cnbright/pascalline/archive/README.md

# 历史资料

`v1/` 保留早期建模、原理图、静态姿态工具和打印评估；其中弹性爪、导向支承和行程设计已由根目录 V0.2 替代。旧图、价格估算和旧 README 中的文件链接不代表当前交付，也不保证仍可直接访问。

`history/` 保存后来被替换的几何验证实现，不能作为当前通过证据。当前入口为根目录 `tools/rebuild.py`，当前打印文件为 `exports/obj/`。

未收录可以重新生成的大型 Blender 缓存、临时日志、网页抓取缓存和旧打印件。保留历史原理图的生成源码与轮廓；重画旧图另需 Matplotlib，不属于当前 requirements.txt 的恢复必需依赖。
