cnbright/pascalline/exports/part_previews/base.png

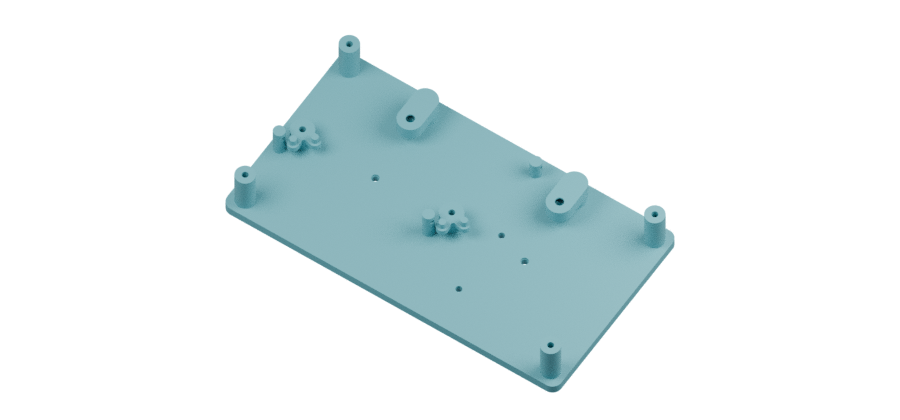
exports/part_previews/base.png
