cnbright/pascalline/exports/part_previews/carry_slider.png

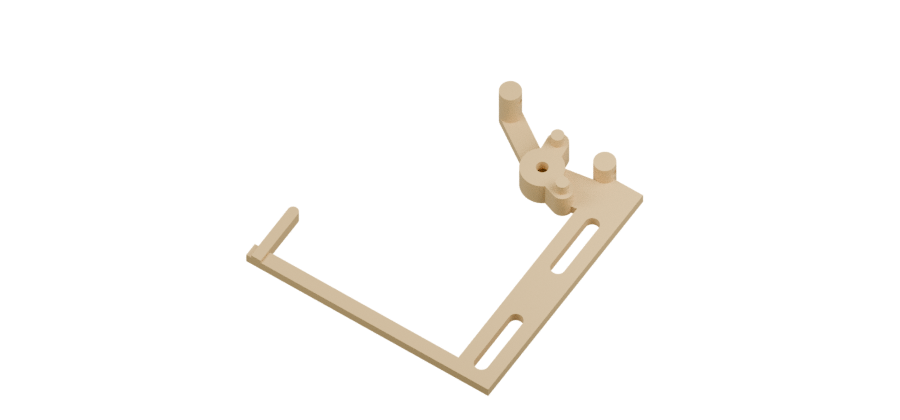
exports/part_previews/carry_slider.png
