cnbright/pascalline/exports/part_previews/digit_wheel.png

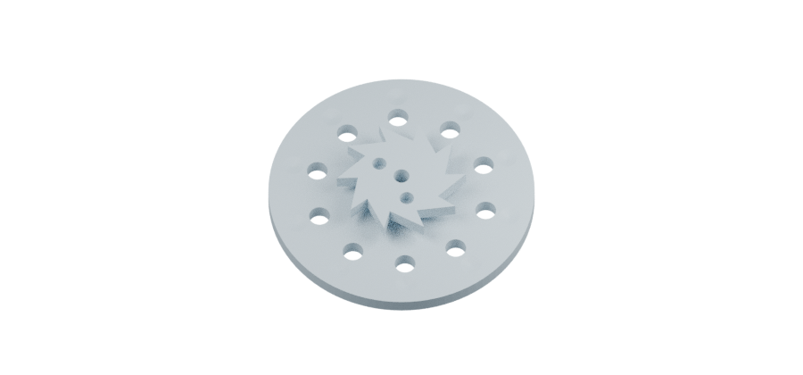
exports/part_previews/digit_wheel.png
