cnbright/pascalline/exports/part_previews/drive_pawl.png

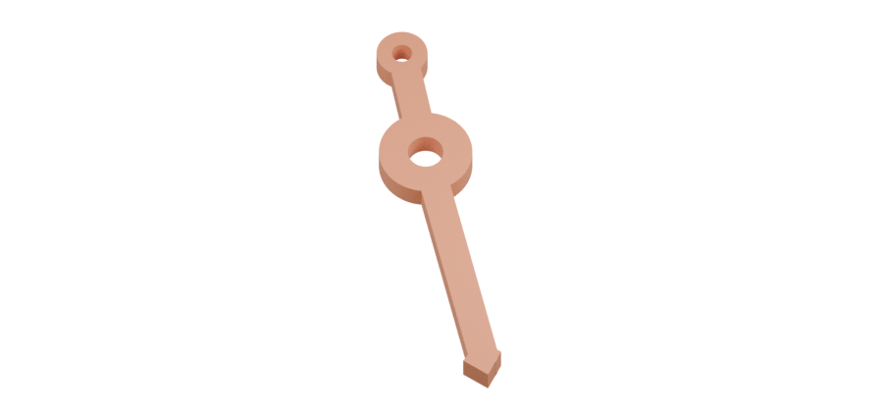
exports/part_previews/drive_pawl.png
