cnbright/pascalline/exports/part_previews/stop_pawl.png

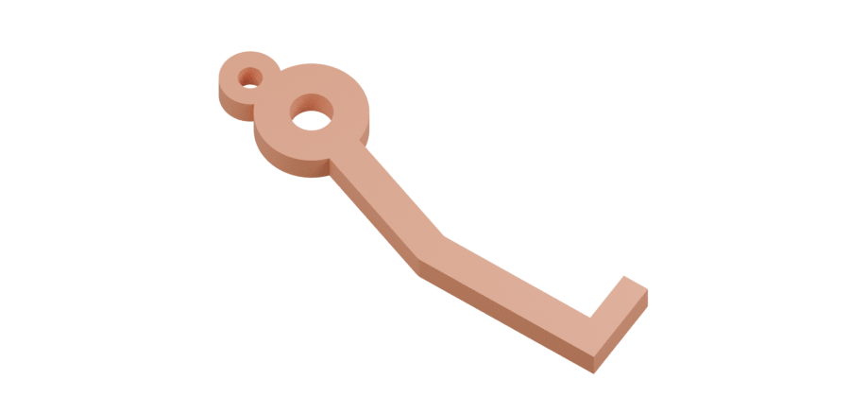
exports/part_previews/stop_pawl.png
