cnbright/pascalline/exports/part_previews/top_cover.png

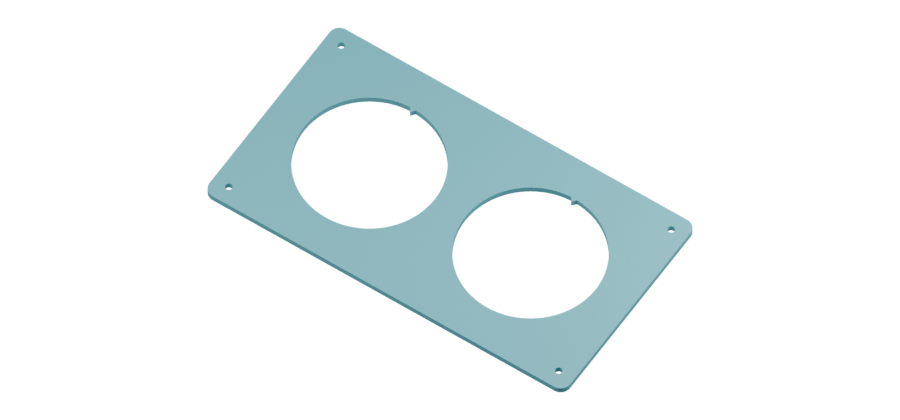
exports/part_previews/top_cover.png
