cnbright/pascalline/HARDWARE.csv

项目 | 规格 | 数量 | 单位 | 适用 | 用途与核对说明
金属轴管 | 外径4/内径3.2/长度25 mm | 2 | 段 | 必需 | 两轮空心轴；装配Z4到29；端面磨平去毛刺；内孔可自由通过M3
金属导向套 | 外径4/内径3.2/长度5 mm | 2 | 段 | 必需 | 固定位置(67 -30)和(67 6)；套顶Z10；外圆须平滑
金属枢轴套 | 外径4/内径3.2/长度4 mm | 3 | 段 | 必需 | 两止回爪加一驱动爪；套顶Z18
M3低圆头螺钉 | M3×35 头下长度 | 2 | 根 | 必需 | 轴管夹紧；配0.5mm上垫时尖端约Z-5.5
M3低圆头螺钉 | M3×16 头下长度 | 2 | 根 | 必需 | 滑架导向；不能直接加长为×18；需核对脚下净空
M3低圆头螺钉 | M3×25 头下长度 | 2 | 根 | 必需 | 固定止回爪穿底板；尖端约Z-6.5；8mm底脚名义余量1.5mm
M3低圆头螺钉 | M3×12 头下长度 | 1 | 根 | 必需 | 驱动爪；尖端约Z6.5；禁止直接换×14
M3上压平垫 | 内孔约3.2/外径约7/厚0.5 mm | 7 | 片 | 必需 | 轴2片加导向2片加三爪3片；必须压在金属套端面而非夹死运动件
M3底部平垫 | 内孔约3.2/外径7至9/厚0.5 mm | 6 | 片 | 必需 | 轴2片加导向2片加固定止回爪2片；分散底板局部压力
M3防松螺母 | M3尼龙锁紧型 高约4 mm | 6 | 个 | 必需 | 轴2个加导向2个加固定止回爪2个；实测高度改变后重算螺纹外露
M3普通六角螺母 | M3 对边5.5/厚2.4 mm | 1 | 个 | 必需 | 仅驱动爪座侧装；不能用较厚锁母代替
M4孔径下支承垫圈 | 内孔约4.3/外径8至9/厚1.0 mm | 2 | 片 | 必需 | 滑架下支承；可用实测0.8加0.2mm组合达到1.0mm
M4孔径上限位垫圈 | 内孔约4.3/外径8至9/厚0.8 mm | 2 | 片 | 必需 | 滑架上方浮动限位；名义防翘余隙0.2mm
M4孔径枢轴下调整垫 | 内孔约4.3/外径8至9/厚0.2 mm | 3 | 片 | 必需 | 三爪各一片；配合实测爪厚调整
M4孔径枢轴上调整垫 | 内孔约4.3/外径8至9/厚0.5 mm | 3 | 片 | 必需 | 三爪各一片；与L4套和3mm爪组成名义0.3mm轴隙
M4弹簧钢珠定位柱 | M4短体约8mm/球径约2.5mm/可用压缩行程至少0.7mm | 2 | 个 | 必需 | 核实供应商实物尺寸；自由球顶调至Z21.65且金属体顶低于21底高于10
M4普通六角螺母 | M4 对边7/厚约3.2 mm | 2 | 个 | 必需 | 钢珠支架侧装螺母；槽高约3.5mm
轻回位元件 | 可调弹力线或适配轻小拉簧 | 4 | 根 | 必需 | 三爪各一根加滑架一根；滑架端距约7.5至22.4mm；2.4mm穿线孔
橡胶底脚 | 约8mm高 自粘或可靠胶粘 | 4 | 个 | 必需 | 避开底部紧固件；检查压缩后螺钉不触桌；不足时加高
环氧胶 | 适配固化树脂和所选金属 | 少量 | 份 | 必需 | 仅胶固固定下轴套与管及底法兰与底座；校直固化；不得粘旋转面
螺纹防松用品 | 适配金属小螺纹的可复查防松措施 | 少量 | 份 | 按需 | 驱动侧装普通螺母及钢珠调节螺纹等；避免胶液进入树脂配合面和钢珠机构
薄调整垫片 | 内孔适配4mm套的多种薄厚规格 | 少量 | 组 | 按需 | 用于实物公差选配；不得以强拧螺钉消除间隙
M3盖板螺钉 | M3×35 头下长度 | 4 | 根 | 仅装盖板 | 盖板Z26.5到29.5；配0.5mm上垫；不要换×40
M3盖板平垫 | 内孔约3.2/厚0.5 mm | 8 | 片 | 仅装盖板 | 上4片下4片；厚度变化须重算长度
M3盖板普通六角螺母 | M3 对边5.5/厚2.4 mm | 4 | 个 | 仅装盖板 | 约有2.1mm螺纹露出；须防松；换高4mm锁母只余约0.5mm须确认啮合
