cnbright/pascalline/exports/print_parts_overview.pdf

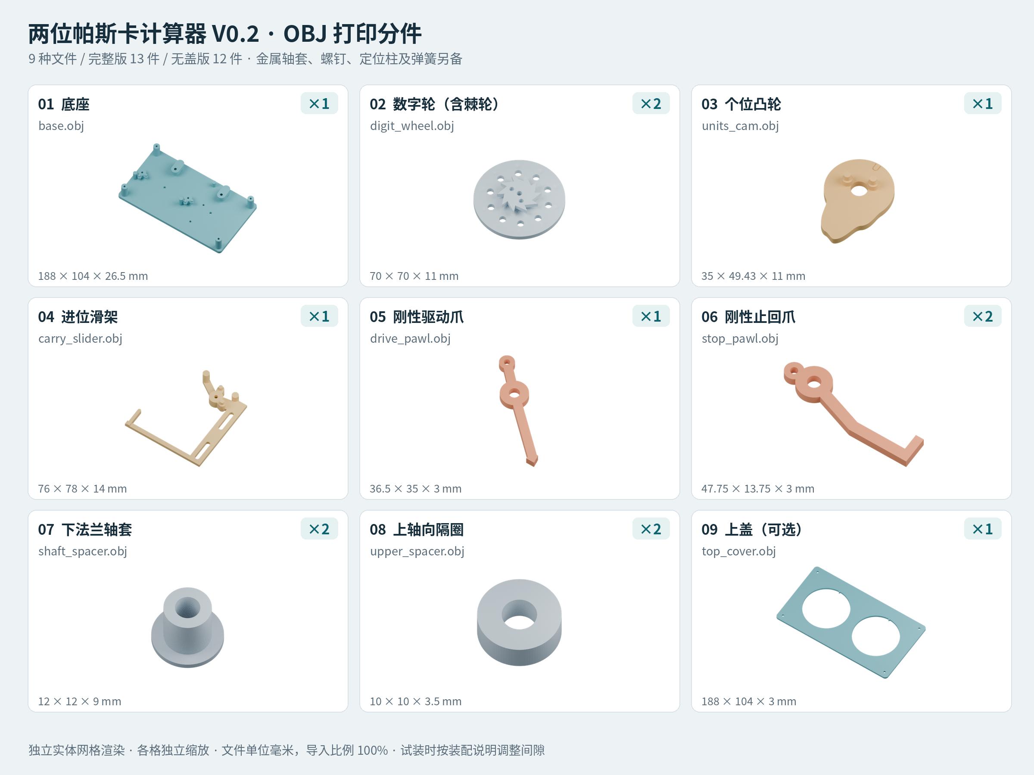
[picture p8: page 1]
