cnbright/pascalline/exports/parts.csv

文件 | 中文名称 | 数量 | 可选 | 单位 | X尺寸_mm | Y尺寸_mm | Z尺寸_mm | 单件体积_cm3 | 备注
obj/base.obj | 底座 | 1 | 否 | mm | 188.000 | 104.000 | 26.500 | 111.366394 | 每文件仅一个零件；请按数量生产
obj/digit_wheel.obj | 数字轮（含棘轮） | 2 | 否 | mm | 70.000 | 70.000 | 11.000 | 17.161875 | 每文件仅一个零件；请按数量生产
obj/units_cam.obj | 个位凸轮 | 1 | 否 | mm | 35.000 | 49.426 | 11.000 | 4.876861 | 每文件仅一个零件；请按数量生产
obj/carry_slider.obj | 进位滑架 | 1 | 否 | mm | 76.000 | 78.000 | 14.000 | 5.397358 | 每文件仅一个零件；请按数量生产
obj/drive_pawl.obj | 驱动拨爪 | 1 | 否 | mm | 36.500 | 35.000 | 3.000 | 0.649323 | 每文件仅一个零件；请按数量生产
obj/stop_pawl.obj | 止回爪 | 2 | 否 | mm | 47.750 | 13.750 | 3.000 | 0.699666 | 每文件仅一个零件；请按数量生产
obj/shaft_spacer.obj | 下法兰轴套 | 2 | 否 | mm | 12.000 | 12.000 | 9.000 | 0.390253 | 每文件仅一个零件；请按数量生产
obj/upper_spacer.obj | 上轴向隔圈 | 2 | 否 | mm | 10.000 | 10.000 | 3.500 | 0.226237 | 每文件仅一个零件；请按数量生产
obj/top_cover.obj | 上盖 | 1 | 是 | mm | 188.000 | 104.000 | 3.000 | 36.725614 | 每文件仅一个零件；请按数量生产；盖板可省略
