cnbright/pascalline/exports/top_cover.stl

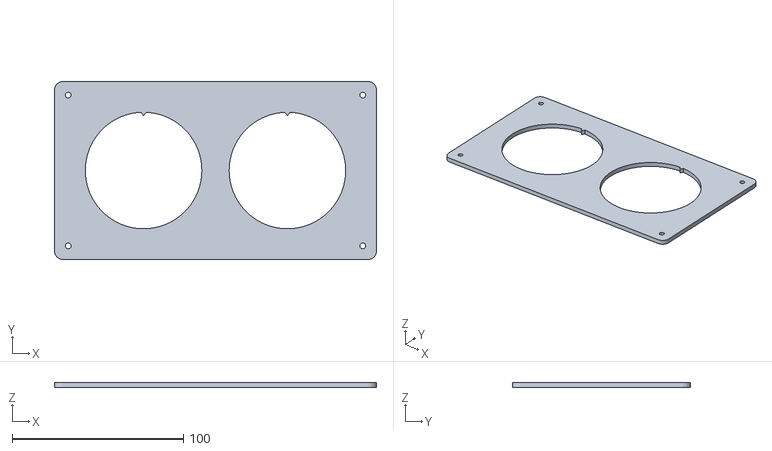
[picture p9: CAD file, 2026-10-18]
exports/top_cover.stl
188.0 x 104.0 x 3.00
