cnbright/pascalline/exports/units_cam.stl

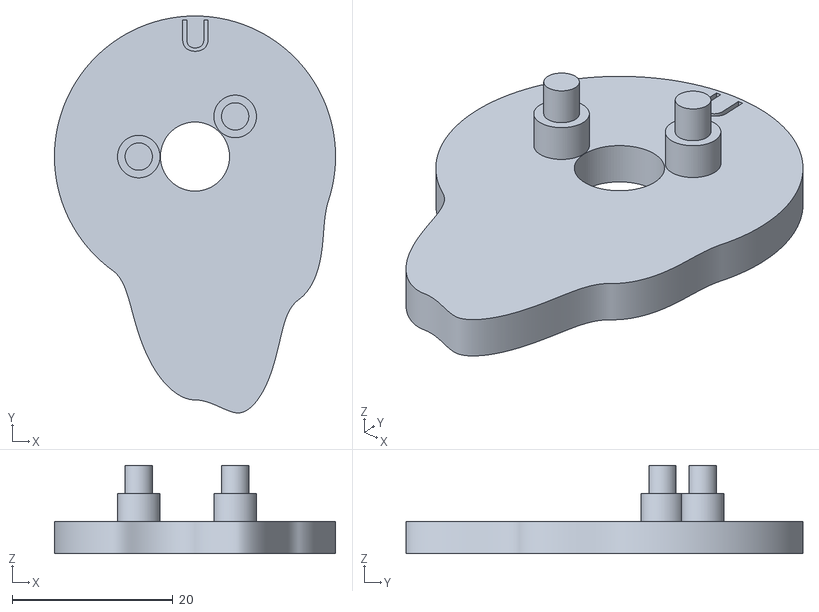
[picture p10: CAD file, 2026-10-18]
exports/units_cam.stl
35.0 x 49.4 x 11.0
