cnbright/pascalline/exports/digit_wheel.stl

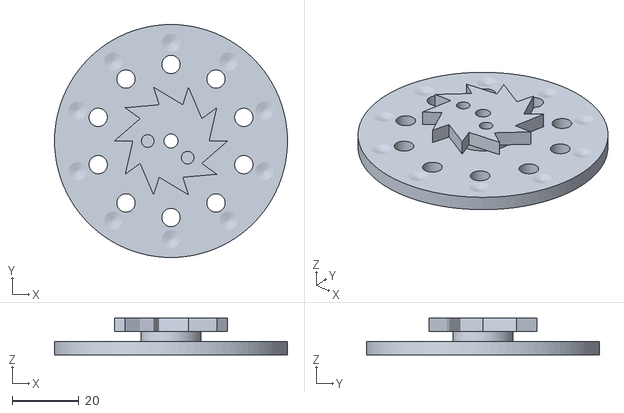
[picture p11: CAD file, 2026-10-18]
exports/digit_wheel.stl
70.0 x 70.0 x 11.0
