cnbright/pascalline/exports/shaft_spacer.stl

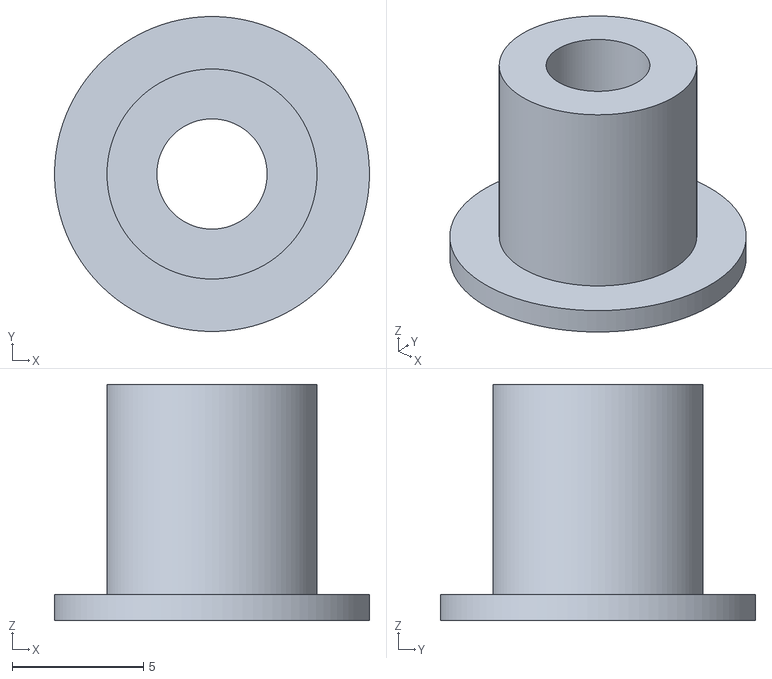
[picture p12: CAD file, 2026-10-18]
exports/shaft_spacer.stl
12.0 x 12.0 x 9.00
