cnbright/pascalline/exports/drive_pawl.stl

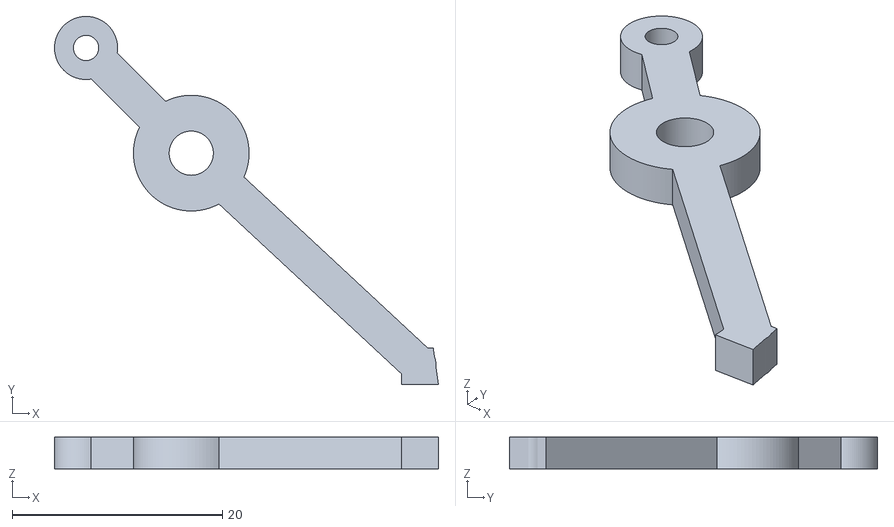
[picture p13: CAD file, 2026-10-18]
exports/drive_pawl.stl
36.5 x 35.0 x 3.00
