cnbright/pascalline/exports/base.stl

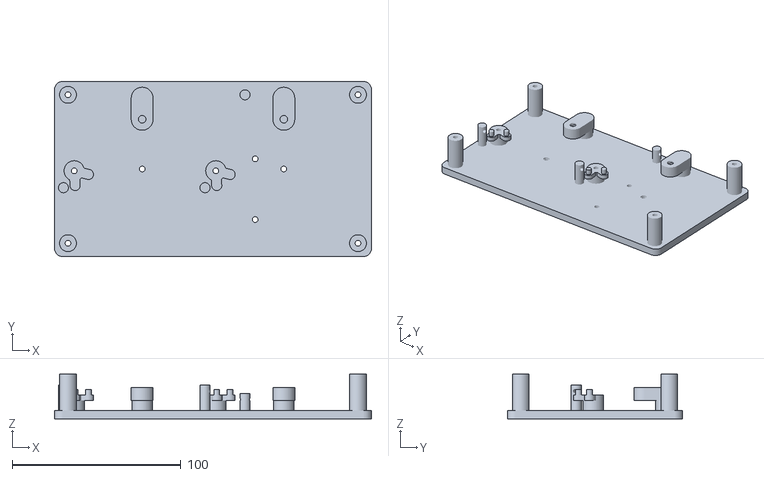
[picture p14: CAD file, 2026-10-18]
exports/base.stl
188.0 x 104.0 x 26.5
