cnbright/pascalline/exports/upper_spacer.stl

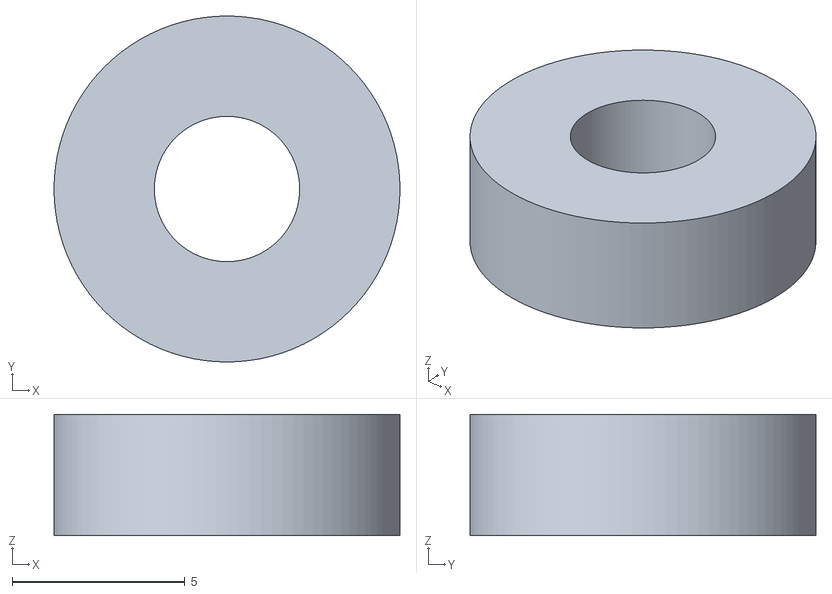
[picture p15: CAD file, 2026-10-18]
exports/upper_spacer.stl
10.0 x 10.0 x 3.50
