cnbright/pascalline/exports/stop_pawl.stl

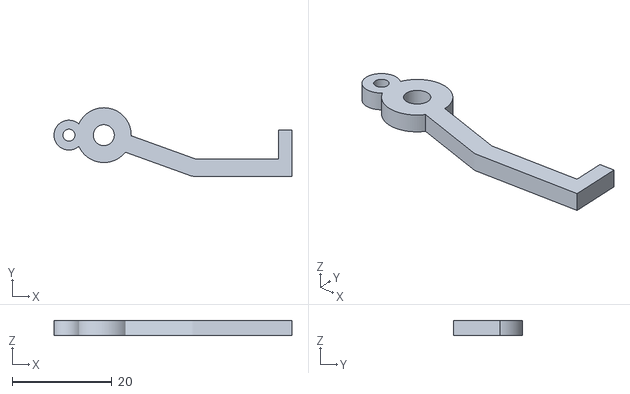
[picture p16: CAD file, 2026-10-18]
exports/stop_pawl.stl
47.8 x 13.8 x 3.00
