cnbright/pascalline/exports/carry_slider.stl

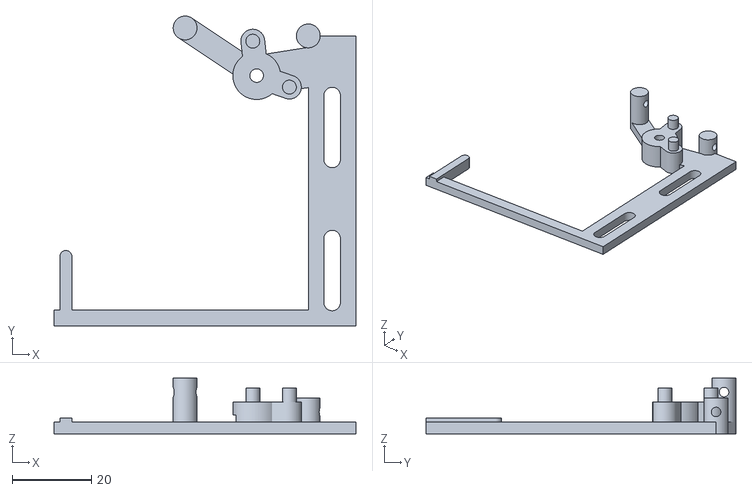
[picture p17: CAD file, 2026-10-18]
exports/carry_slider.stl
76.0 x 78.0 x 14.0
