cnbright/pascalline/(list of files, cad)

Other CAD files:
archive/v1/drawings/source/drive_pawl.scad
archive/v1/pascaline.scad
archive/v1/drawings/source/carry_slider.scad
archive/v1/drawings/source/ratchet_section.scad
archive/v1/drawings/source/stop_pawl.scad
archive/v1/drawings/source/units_cam.scad
