cnbright/pascalline/ASSEMBLY.md

# 帕斯卡两位计算器 V0.2：装配与调试

本版使用刚性打印爪、金属轴套、外置回位簧和弹簧钢珠定位。打印件建议使用 **9600 白树脂**；三只爪靠枢轴转动让位，**不能把树脂梁当弹片掰弯**。目前未做实物试打、寿命或负载验证，文件通过网格检查不代表量产可靠。

## 1. 清点零件与方向

| 打印文件 | 名称 | 数量 |
|---|---|---:|
| `base.obj` | 底座 | 1 |
| `digit_wheel.obj` | 数字轮，含棘轮 | 2 |
| `units_cam.obj` | 个位凸轮 | 1 |
| `carry_slider.obj` | 进位滑架 | 1 |
| `drive_pawl.obj` | 驱动拨爪 | 1 |
| `stop_pawl.obj` | 止回爪 | 2 |
| `shaft_spacer.obj` | 固定下法兰轴套 | 2 |
| `upper_spacer.obj` | 上轴向隔圈 | 2 |
| `top_cover.obj` | 上盖，可选 | 1 |

共 **9 种、13 件**；不装盖板为 **8 种、12 件**。每个 OBJ 只含一个零件，重复件按数量制造。OBJ 坐标单位按 **mm** 导入，禁止为补偿孔配合而整体缩放；数字轮导出时盘面朝下，装配时将有数字的一面朝上。

俯视时，左轮为个位，右轮为十位；读数先看右侧十位、再看左侧个位。两个轮均逆时针前进，每档 36°。读数位置在两个轴的 +Y 方向，即钢珠支架一侧。没有盖板时，在固定支架上补两个读数指示标记，不能用会跟轮转动的标记代替。

五金见同目录 `HARDWARE.csv`。除可选盖板五金外，核心用量是：7 根 M3 螺钉、6 个 M3 锁母、1 个侧装普通 M3 螺母、13 片 M3 平垫、10 片不同厚度的 M4 孔径垫片、7 段金属管、2 个弹簧钢珠定位柱和 4 根回位元件。

## 2. 打印后先处理配合面

去除支撑、清洗并完成材料要求的固化。支撑痕和涂层不能留在棘齿工作面、凸轮外轮廓、随动圆头、钢珠凹位、轴孔、滑槽和承托端面。数字可填色，但保护这些配合面。

以下是**成品配合目标**，不是免加工承诺。先测金属外径，再量打印件；用合适量规、细锉、铰刀和细砂纸逐步修整。孔已经偏大时不要继续扩孔，应换衬套或重做该件；不要用全局缩放同时改变轴距和进位几何。

| 位置 | 修整／检查目标 |
|---|---|
| 两个滑槽的宽度 | 实测导套外径 + 0.12～0.16 mm；若导套确为 4.00 mm，则为 4.12～4.16 mm |
| 数字轮、爪及隔圈的 4 mm 类孔 | 实测所配管外径 + 0.10～0.15 mm；固定下轴套还需完成下述胶固 |
| 底座轴管定位浅孔 | 实测轴管外径 + 约 0.05 mm，深度 1 mm；不得强压过盈装入 |
| 螺钉通孔 | 螺钉能自由穿过；螺纹不应在树脂内强行攻入 |
| 六角螺母侧装口 | 螺母能装入、保持平正；不能靠猛压把树脂槽挤裂 |
| 金属管端面 | 无毛刺、平整并垂直于轴线；按实测长度核对叠层 |

滑架起点、中点和终点都应顺滑，刚性部位的左右总摆幅目标不超过 0.20～0.30 mm。两个导套需要平行对齐；装配校准后再紧固，不能强行用两根螺钉把不对齐的槽拉直。鼻端的实际进位行程还要单独验收，不能由槽宽合格直接推出。

## 3. 先装轴管、固定下轴套和底脚

每根轴使用 **OD4 / ID3.2 / L25 mm** 金属管；下端落在底座 1 mm 深定位孔内，装配坐标为 Z=4～29。M3×35 螺钉从顶部穿过管内，底部用 0.5 mm 平垫和锁母锁定。

1. 在底座四角下方贴约 8 mm 高的橡胶脚，避开通孔和螺母。最深的止回爪螺钉会到 Z≈−6.5；8 mm 脚的名义余量只有 1.5 mm。装好全部五金后，检查脚压缩和底板翘曲仍不会让螺钉触桌；不足时增加脚高或垫高。
2. 两根管插入浅孔，套上两个固定下法兰轴套。下轴套底面 Z=5，顶面 Z=14；较宽法兰在下。
3. 先干装检查轴距 84 mm、轴管垂直、下轴套端面平正。轮盘试套后应能自由旋转，不靠晃斜轴管才能转动。
4. 将轴管与固定下轴套的孔壁、下轴套底法兰与底座用少量环氧胶固定，保持校直直到固化。1 mm 深浅孔本身不承担全部抗倾斜定位。**胶只用于这些固定接合面，不得进入管内、轮孔、凸轮孔或任何旋转／承托表面。**
5. 螺母轻紧防松即可。管端只有很小的环形承压面积，不按常规金属 M3 接头的扭矩猛拧树脂底座。

两轴顶部均使用上轴向隔圈：盘顶 Z=25，隔圈高 3.5 mm，顶面到 Z=28.5。上 M3 压垫圈压在管端 Z=29，保留约 0.5 mm 的名义轴向自由量。实际装配时以盘能自由转动、不会抬起脱开为准；不能让上压垫圈直接夹死轮盘。

## 4. 装滑架金属导向

两个固定导向位置为 **(67,−30)**、**(67,6) mm**，沿 Y 相隔 36 mm。不要照 V1 采用两个同 Y 的横排导柱。

每处从下到上依次为：

1. 底座顶面 Z=5。
2. L5 金属导套直接立在底座上，顶端 Z=10；套外放内孔约 4.3 mm、厚 1.0 mm 的下支承垫圈。
3. 滑架厚 3 mm 的导向板放在下垫圈上，底面 Z=6、顶面 Z=9。
4. 导套外再套厚 0.8 mm 的 M4 孔径限位垫圈。
5. 最上方放厚 0.5 mm 的 M3 压垫圈，压住金属导套顶端；M3×16 圆头螺钉穿过管和底板，底部加平垫、锁母。

名义防翘间隙为 **5−1−3−0.8=0.2 mm**。上 M4 垫圈可浮动，无上抬载荷时可能落在滑架上；被抬起后由上压垫圈限位。M3 螺钉的刚性夹紧路径通过金属导套，滑架不在该路径里。不得用“把螺母拧松一点”来获得滑动自由。

下支承垫圈必须能套过 OD4 管，不能误用内孔约 3.2 mm 的 M3 垫圈。按实测厚度选配薄垫，使轴向间隙约 0.15～0.25 mm；两侧支承高度要一致。

暂不挂弹簧，先手推全行程。凸轮 lift 从 −4.5 到 +10.4 mm，滑架的**总活动范围是 14.9 mm**；10.4 mm 是工作推程参数，不是整段滑槽行程。全程不能撞槽端、刮底板或被螺钉头挡住。

## 5. 装三只刚性爪与回位元件

三只爪均厚 3 mm，主要梁宽约 3.5 mm；通过枢轴摆动让齿，回位由外置弹簧／弹力线完成。不要打印弹片替代，也不要强掰刚性爪。

每处枢轴使用 **OD4 / ID3.2 / L4 mm** 金属套。固定止回爪座顶面和滑架驱动爪座顶面均为 Z=14。套外依次装厚 0.2 mm 下垫、3 mm 爪、厚 0.5 mm 上垫，套顶加厚 0.5 mm 的 M3 压垫圈：

`4 − 0.2 − 3 − 0.5 = 0.3 mm`

用薄垫实配，将枢轴轴向余隙调到约 **0.2～0.3 mm**。带下垫后的实体爪底面约为 Z=14.2；示意装配模型的基准姿态没有画齐全部调整垫片，不能把它当作成品间隙测量。

- 两只固定止回爪各用 **M3×25**，穿过 9 mm 高座和底板，底部用平垫、锁母。两只方向相同，按各自座上的闭合限位落位。
- 驱动拨爪用 **M3×12**，从上方穿过枢轴，在滑架 8 mm 高座的侧口中装一枚 **2.4 mm 厚普通 M3 六角螺母**。不使用较厚尼龙锁母填这个侧口，也不能擅自改用 ×14 螺钉。
- 手拨每只爪，确认其自由回摆、能接触闭合限位，并能在让齿时转开；不能靠树脂梁弯曲完成动作。最大开角由该版限位几何决定，不靠用力掰到某个角度验收。

外置回位元件共 **4 根**：两只止回爪各一根、驱动爪一根、滑架一根。所有相关穿线孔均为 2.4 mm；将爪尾孔连到对应的弹簧锚点，滑架回位孔连到底座锚点。力只需足以稳定回位，过强会增加磨损和拨动力。

滑架回位锚距随动作约为 **7.5～22.4 mm**。优先使用可调长度弹力线；如用小拉簧，须核对其带钩总长、预紧和最大允许伸长，使全程不松脱、不拉到极限。其余三根也以实际动作选张力和长度，不给未经实测的线径／刚度作为保证。

## 6. 装弹簧钢珠与数字轮

每轮下方一个 **M4 短体弹簧钢珠定位柱**，共 2 个。采购时确认：主体长约 8 mm、球径约 2.5 mm、可用压缩行程至少 0.7 mm。普通 M4 球头柱塞的行程并不统一，不能只按“M4”购买。

1. 从侧窗分别放入 M4 普通六角螺母，按标准厚约 3.2 mm 选件；模型侧槽高度约 3.5 mm。
2. 旋入钢珠柱塞，先调低，避免装轮时硬顶。轮盘底面在 Z=21，定位凹位口径 5.5 mm、深约 0.6 mm。
3. 目标自由球顶高度为 **21+0.6+0.05=21.65 mm**。必须同时满足金属主体顶面 **低于 Z=21**、主体底面 **高于 Z=10**。约 8 mm 主体、约 0.8 mm 球外露时，可参考主体 Z≈12.85～20.85；以实物尺寸调整。
4. 球经过平坦盘底时需要约 0.65 mm 压缩量，所以要求至少 0.7 mm 行程。若球行程不足或金属体碰盘，不得继续拧高硬挤，应换符合要求的柱塞或返修设计。
5. 高度和预紧以转动顺滑、每 36° 能清楚落入一个定位凹位为准。先逐轮检查十个位置，再挂载进位机构。调好后对金属螺纹做可复查的防松，避免胶液进入球或弹簧。

个位凸轮先放到左侧固定下轴套上。其两根连接销为不对称位置，必须与数字轮底部对应孔配对，不要旋转 180° 强装。凸轮厚盘位于 Z=6～10，销的加粗肩台顶面约 Z=13.5，轮底 Z=14，名义留 0.5 mm 间隙；细销约有 3 mm 入孔长度。实际应有轴向自由，不因销孔或肩台夹紧而卡住凸轮。

再装左右数字轮、上轴向隔圈和上压垫圈，最后轻紧两根 M3×35。将个位 0 标记放在固定读数线，确认凸轮处于相应保持位。固定下轴套的环氧胶此时必须已经固化，轮和凸轮仍可自由转动。

## 7. 螺钉长度核对与可选盖板

下表按上 M3 压垫厚 0.5 mm、底部平垫厚 0.5 mm、M3 锁母高约 4 mm 计算。长度均为**头下长度**。

| 用途 | 螺钉 | 数量 | 头下 Z | 尖端 Z | 核对事项 |
|---|---|---:|---:|---:|---|
| 轮轴 | M3×35 | 2 | 29.5 | −5.5 | 锁母外露约 1 mm 螺纹 |
| 滑架导向 | M3×16 | 2 | 10.5 | −5.5 | 锁母外露约 1 mm；换 ×18 会接近桌面 |
| 固定止回爪 | M3×25 | 2 | 18.5 | −6.5 | 8 mm 脚下仅余约 1.5 mm |
| 驱动爪 | M3×12 | 1 | 18.5 | 6.5 | 高于滑架底 Z=6 约 0.5 mm；换 ×14 会撞底板 |

头型优先低圆头 button head，M3 实际头高约 1.65 mm；不同产品要复核。所有紧固均轻紧防松，不把树脂当成可承受金属接头预紧力的零件。垫片、锁母或螺钉换型号后重新核算，不能只看标称长度。

盖板底面 Z=26.5、厚 3 mm，可先不装。若装盖板，另加 **M3×35×4、M3 平垫×8、普通 M3 螺母×4**；按 0.5 mm 上下平垫、2.4 mm 普通螺母计算，底端仍有约 2.1 mm 螺纹露出。普通螺母需要可复查的防松措施；若改高约 4 mm 的尼龙锁母，外露仅约 0.5 mm，须实配确认锁紧段已充分啮合。不要直接换成 ×40：它会伸到约 Z=−10，低于 8 mm 底脚。

## 8. 进位相位与验收

从顶部看，个位正向逆时针旋转。凸轮程序规定如下，滑架 Y 位移为 lift 的相反数：

| 个位角度 | lift 变化 | 目的 |
|---|---|---|
| 0～36° | +8.3 → −4.5 mm | 0→1 时复位 |
| 36～288° | 保持 −4.5 mm | 常规拨数低位 |
| 288～324° | −4.5 → 0 mm | 8→9 的预行程，不能造成十位提前进位 |
| 324～350° | 0 → +10.4 mm | 9→0 的工作推动 |
| 350～360° | +10.4 → +8.3 mm | 退让，让钢珠把十位锁入目标档 |

这张表说明设计动作；CAD 中十位姿态是规定输入，不是接触仿真的结果。实体应在停止拨动后稳定在一个数字档，不能停在两档之间，也不能因退让反拖十位。

先低张力、慢速手动试验：逐轮检查自由转动和钢珠定位；再装爪和回位元件；最后接入个位凸轮。发现卡滞先停止，卸载回位力检查配合，不强拧数字轮或掰树脂爪。

正式记录至少 **100 次慢速进位事件**。可从 00 开始，只拨个位 100 圈，共 1000 档；应恰好发生 100 次十位进位，最后回到 00。重点逐项检查：

- **08→09**：只增加个位，预行程不使十位提前跳档。
- **09→10**：十位只前进一档，松手后钢珠完整落位。
- **10→11**：复位不带回十位，驱动爪能让齿进入低位；下一次 8→9 预行程结束时再回到闭合位置。
- **99→00**：两个轮均回 0，不多走一档；实体没有百位或溢出指示，需自行记下溢出。
- 全行程无螺钉触底、槽端撞击、异常刮擦、双进位或漏进位；连续过程中无明显松动和磨屑。

记录所用材料、实测管径／槽宽／垫片厚度、钢珠型号和回位张力调整。若未通过，先定位是导向、定位钢珠、回位还是齿面问题，再修整或改件；不得把软件算术测试通过当成实物通过。

一次完成一档并等待钢珠落位后，再操作另一只轮。检查中发现，强行把滑架推到高位、同时手动把两只爪掰到任意大开角，可能使两爪相碰；正常规定工作/回程路径及停位手拨检查未经过这些组合。不要把独立极限姿态当成允许的操作方式。

复位时先把个位继续正向拨到 0，再把十位正向拨到 0。止回机构存在时不强行反转。完成这轮验证后，才适合讨论加速操作、长期磨损及扩展位数。
