cnbright/pascalline/PRINT_START.txt

两位帕斯卡计算器 V0.2 — OBJ 打印包

OBJ 文件：9 种；完整套件共 13 件，去掉 top_cover 为 12 件。
各文件只含一个独立封闭实体，无需 MTL 或纹理文件。
单位：毫米。导入比例：100%。底座应为 188×104×26.5 mm，数字轮应为70×70×11 mm。
按 parts.csv 填数量：digit_wheel、stop_pawl、shaft_spacer、upper_spacer 各2件；其它各1件。

本版所有打印件均为刚性件，可优先询价9600白树脂。
三只爪已经改为转轴+外置弹簧，不能省去配套金属件和弹簧。
必须阅读 ASSEMBLY.md 和 HARDWARE.csv；孔槽按实际五金修整，先无盖试装调试。
打印商调整支撑/摆放时请保护凸轮、棘齿、定位凹位及滑槽的配合面，不要整体缩放。

已完成网格及名义几何检查，尚未实物试打和寿命验证。
本包是V0.2修订版，不与V0.1零件混装。
