cnbright/pascalline/archive/v1/ASSEMBLY.md

# 两位原型装配与调试

本说明适用于 `pascaline.scad` 的默认尺寸。它描述设计意图和首轮打样步骤，尚不是经过实物验证的装配工艺。

**2026-10-12 审查补充：下文为原版设计意图，不能直接作为嘉立创普通树脂装配工艺。** 滑块需补约 1 mm 支承，导向柱和轴定位需改进，进位需控制间隙并预留可调行程。先阅读 [JLC_PRINT_REVIEW.md](JLC_PRINT_REVIEW.md)；CAD 尚未据此修订。

## 机构和尺寸

从顶部观察，**左侧是个位 UNITS，右侧是十位 TENS**。这是便于观察传动的试验台排布；读数应先读右侧十位，再读左侧个位，例如左 5、右 1 表示 15。后续产品外壳可调整为常见的高位在左布局。

底座为 188×104 mm，轴中心距 84 mm，数字盘直径 70 mm。每轮 10 档，每档正向逆时针转 36°。底座厚 5 mm；凸轮工作层在 Z=6–10 mm，棘轮与拨爪工作层在 Z=12–16 mm，数字盘在 Z=19–23 mm，盖板从 Z=24.5 mm 开始。盖板上的固定三角指针位于各轮 12 点方向。

进位动作链：

1. 从 9 转到 0 时，个位凸轮推动滑块向下移动。
2. 滑块上的弹性拨爪压住十位棘轮齿面，目标是推进十位一档。
3. 十位止回爪阻止倒转；下一次个位 0→1 时，外加橡皮筋/拉簧拉回滑块，驱动拨爪沿齿坡让位。
4. 个位 1→9 期间，滑块保持低升程位置，十位不应移动。

`carry_stroke = 12.5 × tan(36°) ≈ 9.082 mm` 来自拨爪接触点的理想几何。凸轮按半径 1.5 mm 的圆头从动件做轮廓偏置，升程与回程采用平滑曲线。它不包含打印弹性、接触变形、摩擦和动态冲击；行程正确不等于实物已保证每次进一齿。

## 打印件

| 文件 | 数量 | 用途与建议 |
| --- | ---: | --- |
| `base.stl` | 1 | 底座、导向柱及固定爪支座，PLA/PETG |
| `digit_wheel.stl` | 2 | 共用数字盘与十齿棘轮，单件导出已盘面朝下 |
| `units_cam.stl` | 1 | 个位凸轮与传动销，平底朝下 |
| `carry_slider.stl` | 1 | 阶梯滑块与圆头从动件，平底朝下 |
| `drive_pawl.stl` | 1 | 滑块上的弹性驱动爪，优先 PETG |
| `stop_pawl.stl` | 2 | 两轮的弹性止回爪，优先 PETG |
| `shaft_spacer.stl` | 2 | 法兰轴套，套筒外径 8、内径 4.4、总高 7 mm；底部法兰直径 12、厚 1 mm |
| `top_cover.stl` | 1 | 可选盖板、轮位标签和读数指针 |

共 8 种、11 个打印件。建议先用 0.2 mm 层高、4 圈外壁、约 35% 填充；弹性爪平放打印，使弯曲发生在打印层平面内。上述设置只是起点，取决于耗材与机器。盘面朝下时数字为浅凹刻字，切片后检查首层文字是否能保留，可用油漆笔填色。

基座与盖板分别放入切片软件排版；源码中的 `print` 模式用于检查所有零件，并非单张通用打印床排版。若第一层扩张明显，清理轴孔、导槽和棘齿边缘，不要强行压装。

## 建议五金

以下规格须在切片和装配时核对实际成品厚度：

| 五金 | 数量 | 说明 |
| --- | ---: | --- |
| M4×30 圆头螺栓 | 2 | 作为数字轮轴；尽量使用接触段平滑的轴/螺栓 |
| M4 自锁螺母 | 2 | 保持轴向间隙，不能将数字轮夹死 |
| M4 薄垫片 | 2–4 | 优先放在上部螺母下；若放入底部，须重新核对工作层高度 |
| M2×10 小螺钉 | 4 | 固定两个止回爪 |
| M2×8 小螺钉 | 4 | 2 个固定驱动爪，2 个用于滑块导向柱 |
| M2 宽垫片 | 2 | 防止滑块离开导向柱，需大于导槽宽度 |
| M3×8 小螺钉 | 4 | 可选盖板 |
| 轻拉簧或橡皮筋 | 1 | 连接底座和滑块的复位挂柱 |

固定孔按小螺钉直接拧入塑料设计；普通机螺钉可先低速攻丝，避免撑裂细柱。滑块复位连接点为基座 `(61,36)` 与滑块 `(61,24−升程)`，工作长度约 12–21 mm。应选能保持从动件贴住凸轮的轻弹力，过强会明显增加拨轮阻力。

## 装配顺序

1. 清理并试配轴孔、导槽、棘齿与销孔。默认 4 mm 轴孔为 4.4 mm，凸轮销为 3.4 mm、配合孔为 3.8 mm；这些是直径值，不是单边间隙。
2. 将两根轴装入底座。法兰轴套直接落在底座 Z=5 mm 顶面；法兰顶 Z=6 mm 支承凸轮，套筒顶 Z=12 mm 支承数字轮棘轮底面。不要在轴套下随意加厚垫片改变高度。先只装十位轮，确认转动顺畅。
3. 安装两个固定止回爪，使工作鼻顶在棘轮径向齿面上。止回爪应允许正向拨动，轻微反向施力时能挡住轮子。
4. 将滑块放入两个导向柱，再用宽垫片与螺钉限制抬起。不要锁紧滑块；它应在整个约 9.1 mm 行程内自由移动。
5. 把驱动爪固定在滑块的高台上，使其与十位棘轮处于同一高度。单独往返滑块，检查工作行程推进一齿、回程不带回轮子。
6. 将个位凸轮与个位轮通过双销连接，装在个位轴上。两销位于 `(-7,0)` 和 `(5,5)`，不对称排布防止转错 180°。凸轮底由法兰支承，销根肩台限制抬起，并留约 0.3 mm 浮动间隙；无需用胶来确定高度。对齐初始相位：指针读 0 时凸轮为最高升程，滑块处于工作行程终点。
7. 接上轻复位弹簧/橡皮筋，并保持所有工作面可见。调好轴向松紧，约留 0.3–0.5 mm 的转动余量，检查凸轮、滑块、棘轮和底座是否擦碰。
8. 完成下面的调试后，再安装盖板。盖板不得压住轮盘，数字盘只向前转动。

首轮调试应慢速、轻力进行。若卡住，先分离可疑零件定位问题，不要通过增大手力来磨合。

## 首轮验收

| 检查 | 通过条件 |
| --- | --- |
| 空载各轮 10 档 | 每档可停住；读数依次 0–9；不倒转 |
| 徒手往返滑块 | 工作行程恰好一齿；回程不退齿、不补进一齿 |
| 08→09 | 十位不动 |
| 09→10 | 个位回到 0，十位只前进一档 |
| 10→11 | 凸轮回程时十位保持 1 |
| 19→20、89→90 | 相同进位行为 |
| 99→00 | 两轮正确回绕；需要操作者自行记住已溢出 |
| 十位单独加 10 | 个位不应被反向带动 |
| 慢速重复 100 次进位 | 无漏进、重进、回退或卡死；记录弹性爪磨损 |

发生漏进时检查行程、相位、爪尖接触高度与弹力；发生重进时检查弹性过冲、止回定位和回程逃齿。修改参数后重新生成零件，不以软件输出正确作为机械验收依据。

实体复位采用正向补足到下一次 00。例如当前 37，可继续输入 63。软件 `reset()` 仅用于设置测试初值。

## 后续扩展顺序

1. 用两位样件确定孔隙、轴套、爪尖和弹性臂尺寸，稳定进位后冻结该版本。
2. 增加百位并专门验证 099→100、999→000 一类连锁进位。当前布局直接复制会使下一位凸轮进入前一级滑块所在空间，须重新分层布置；瞬间驱动方案也会增加连锁负载。多位版不能直接复制零件并宣称可用，可能需要接近历史 sautoir 的分段储能与释放机构。
3. 再考虑紧凑布局、常见的十位在左显示、可靠复位与溢出指示。
4. 减法可另设补数读数方案；若要求直接反向借位，需要重做传动，不能强转当前止回机构。

`pitch`、轮径、孔径、拨爪接触半径等集中在 SCAD 顶部，便于调试。但这些参数存在几何约束，任意改变中心距或轮径后必须重新检查滑块位置和零件干涉。
