cnbright/pascalline/archive/v1/JLC_PRINT_REVIEW.md

# 嘉立创打印适配审查与省钱计划

审查日期：2026-10-12。对象：现有两位 V0.1，`pascaline.scad` 与 `exports/` 八种独立 STL。此次没有修改 CAD、上传模型、取得订单报价或下单。

**结论：文件网格、零件外形尺寸可用于嘉立创打样，但现版尚未通过功能与工艺适配审查，不建议直接按全套普通树脂下单。** 原版面向 FDM/PETG；“网格封闭”不代表能可靠装配、弹性爪耐用或稳定进位。以下功能问题也应在其他工艺打印前处理。

## 适配结果与下单前修正

| 检查项 | 结果及处理 |
| --- | --- |
| 文件 | 8 种独立 STL 均为单一连通实体，网格检查无非流形边、方向错误或退化三角形。采用毫米、100% 比例。装配图 STL 不可作为整机一体打印文件。 |
| 外形尺寸 | 最大零件底座 188×104×24.5 mm；盖板 188×104×3.4 mm。其余件也在官方 SLA/SLS 尺寸包络内。尺寸通过不等于所有细部通过。 |
| 弹性爪 | 驱动爪 1 件、止回爪 2 件，弹性臂宽约 1.2 mm，需反复弯曲逃齿。普通 9600 树脂不宜直接替代原 PETG；3201PA-F 尼龙可作为试制候选，需重核弹性臂长度、根部圆角、变形及寿命。官方特殊悬伸/卡扣结构建议厚度超过 1.5 mm；不能仅加厚弹片，否则刚度和操作力也会增大。 |
| 滑块工作高度 | CAD 将滑块底面放在 Z=6，底座顶面 Z=5；现有导柱未提供支承肩台，实际存在约 1 mm 的落差。需补支承垫片或肩台，并复核爪尖、凸轮从动件的工作高度。 |
| 导向与紧固 | 导柱外径 3.4 mm、底孔 1.5 mm，攻 M2 后局部径向壁厚约 0.7 mm。普通树脂直接攻丝/拧紧容易开裂。优先改金属导向件和穿透紧固；底座轴也需可靠定位。 |
| 进位行程 | 理想行程 9.0818 mm 恰对应 36°，没有正余量。4.4 mm 导槽配 3.4 mm 柱允许名义横移约 ±0.5 mm；若爪的有效接触半径由 12.5 增至 13 mm，同一行程仅推进约 34.94°。需控制间隙、设置可调行程并重新检查全周期，不能仅放大凸轮。 |
| 装配间隙 | 4 mm 轴配 4.4 mm 孔、3.4 mm 销配 3.8 mm 孔，以及 0.3 mm 轴向隙都是名义尺寸。供应商尺寸误差可能消耗这些间隙，应安排孔位小样或钻铰修整、薄垫片调整。不要整体缩放模型，也不要为防卡死而盲目放大所有导向间隙。 |
| 大平面 | 底座与盖板应关注翘曲。询价备注要求保护配合面，避免在棘齿、导槽、轴孔和销孔处留支撑或厚涂层。 |

行程计算是刚性点接触近似，不含弹性、摩擦和冲击。接触半径 12.5 mm 时，齿顶约限制额外行程在 0.906 mm 内；“多推一点”仍需连同齿形、回程及止回位置验证。材料断裂伸长率也不能作为反复弹性变形的许可应变。

## 推荐的省钱路线

按“先完成能观察进位的功能样机”处理。**先修正上述结构，再询价以下无盖方案；当前文件不是已经修正的嘉立创专用版本。**

| 文件 | 数量 | 优先询价材料 | 当前实体体积合计 cm³ |
| --- | ---: | --- | ---: |
| base.stl | 1 | 9600 白树脂 | 103.043 |
| digit_wheel.stl | 2 | 9600 白树脂 | 34.117 |
| units_cam.stl | 1 | 9600 白树脂 | 6.531 |
| carry_slider.stl | 1 | 9600 白树脂 | 3.056 |
| shaft_spacer.stl | 2 | 9600 白树脂 | 0.616 |
| drive_pawl.stl | 1 | 3201PA-F 尼龙试制 | 0.254 |
| stop_pawl.stl | 2 | 3201PA-F 尼龙试制 | 0.937 |
| top_cover.stl | 0 | 首轮不打印 | — |

共 7 种、10 件，当前实体体积约 **148.553 cm³**，其中刚性件 147.362 cm³、三只弹性爪 1.190 cm³。完整 11 件为 185.251 cm³；省去盖板减少 36.698 cm³，即 **19.81% 体积**，不是保证账单降低 19.81%。表内四舍五入会产生 0.001 cm³ 左右的加总差异。结构修订后应重新导出、重新计量。

无盖时把固定读数箭头和 UNITS/TENS 标识贴在底座上；轴向约束由金属轴、垫片及螺母独立完成，不可把轮盘夹死。M4 轴、M2 紧固件、薄垫片、复位弹簧/橡皮筋使用标准件，单独计费。

进一步省钱的重点是底座：它占无盖方案体积约 **69.36%**。下一版可采用底部开放减重槽和加强筋，保留轴座、导向支承、止回爪支座和复位锚点；具体节省量须以修改后的模型为准。不要做无排液孔的密闭空腔。原说明里的“35% 填充”是 FDM 参数，不能直接当作 SLA 减价选项。

不推荐直接拿一块平板代替现有底座：还需恢复导向、7 mm 高止回爪支座、复位锚点与轴定位，否则不是可装配的方案。也不推荐只打印一只棘轮就宣称验证了整套进位。

报价时选原色、常规交期、标准后处理；不加喷漆、染色和加急。各零件独立上传，相同件填写数量，不用细连杆把模型拼成一件。检查不同材料是否增加最低收费或运费；比较“9600 刚性件 + 3201PA-F 三只爪”与整套尼龙的实际到手总价，通常前者材料成本更低，但不能仅凭材料单价保证最低订单价。普通树脂全套虽然可能更便宜，不作为能工作的候选方案。

## 费用能确定到什么程度

已确定的是 STL 实体体积和数量；**未取得嘉立创实时报价，因此没有已核实的总价或绝对最低价**。当前官方材料页将 9600 标为低价等级、3201PA-F 标为下一档，不能把该等级换算成确定元/克。旧活动价、原料粉末单价也不作为本订单价格。

假设树脂密度 1.10 g/cm³、尼龙 1.00 g/cm³，仅用于预算演示，则无盖方案约为树脂 162.10 g、尼龙 1.19 g。密度不是本次供应商实测值，最终采用平台计算的计费重量。

在没有最低收费的简化条件下：

`预算 = 162.10 × 树脂报价(元/g) + 1.19 × 尼龙报价(元/g) + 运费 + 税费 + 五金费`

例如仅假设树脂价为 0.20 / 0.30 / 0.40 元/g，树脂部分分别约 32.42 / 48.63 / 64.84 元；这些是敏感性演示，不是嘉立创实际报价，也不包含尼龙最低收费。三只爪很轻，按文件/件数的最低收费可能比其材料费更重要。

`jlc-review/parts_cost_basis.csv` 保存成本基数；`jlc-review/quote_compare.py` 可输入实际价格估算含盖/无盖方案。它采用简化计费，平台逐件报价优先。

## 通过实物验证后再补外观件

先检查两个轮各自顺转十档、止回和滑块回程，再测 08→09、09→10、10→11、19→20、89→90、99→00。慢速累计 100 次进位，应无漏进、重进、倒退和卡死，再检查弹片磨损；这仍不是长期寿命认证。盖板、多位扩展和外观加工放在此后。

## 官方依据

以下页面于 2026-10-12 核对；工艺和价格以供应商最终审核及订单为准。

- [9600 材料页](https://www.jlc-3dp.cn/materialDetail/042b67386b1645a58c241d01a729d450.html)：SLA、精度约 ±0.2 mm 或 0.3%，普通韧性、低价格等级。作为刚性低价件候选。
- [3201PA-F 材料页](https://www.jlc-3dp.cn/materialDetail/b1856736f54d4308b52ae581ed04a324.html)：SLS、精度约 ±0.3 mm 或 0.4%，韧性较好。作为弹性件试制候选，不构成疲劳保证。
- [官方打印尺寸表](https://www.jlc.com/portal/q7i52801.html)：9600 最大 780×780×530 mm；3201PA-F 最大 400×400×500 mm。现有零件也满足该表给出的最小外形尺寸条件。
- [官方设计指南](https://www.jlc.com/portal/q7i27832.html)：壁厚、细柱、孔、公差、分件及间隙建议。通用活动间隙建议为树脂 0.5 mm、尼龙 0.6 mm；对本机构独立打印后装配的定位配合，应通过后加工和五金控制，不能把通用间隙值机械套用到全部轴孔与导槽。

官方网页和图表的审查缓存保存在 `jlc-review/`，不是报价单。STL 检查记录为 `exports/mesh_report.json`。
