cnbright/pascalline/validation/driver_reset_path.csv

sequence | stroke_mm | cw_opening_degrees
0 | 8.3 | 0.0
1 | 8.280000000000001 | 0.0
2 | 8.280000000000001 | 0.0
3 | 8.260000000000002 | 0.0
4 | 8.260000000000002 | 0.0
5 | 8.25 | 0.0
6 | 8.24 | 0.0
7 | 8.24 | 0.0
8 | 8.22 | 0.0
9 | 8.22 | 0.0
10 | 8.200000000000001 | 0.0
11 | 8.200000000000001 | 0.0
12 | 8.180000000000001 | 0.0
13 | 8.180000000000001 | 0.0
14 | 8.170000000000002 | 0.0
15 | 8.16 | 0.0
16 | 8.16 | 0.0
17 | 8.14 | 0.0
18 | 8.14 | 0.0
19 | 8.120000000000001 | 0.0
20 | 8.120000000000001 | 0.0
21 | 8.100000000000001 | 0.0
22 | 8.100000000000001 | 0.0
23 | 8.09 | 0.0
24 | 8.08 | 0.0
25 | 8.08 | 0.0
26 | 8.06 | 0.0
27 | 8.06 | 0.0
28 | 8.040000000000001 | 0.0
29 | 8.040000000000001 | 0.0
30 | 8.020000000000001 | 0.0
31 | 8.020000000000001 | 0.0
32 | 8.010000000000002 | 0.0
33 | 8.0 | 0.0
34 | 8.0 | 0.0
35 | 7.98 | 0.0
36 | 7.98 | 0.0
37 | 7.960000000000001 | 0.0
38 | 7.960000000000001 | 0.0
39 | 7.950000000000001 | 0.0
40 | 7.94 | 0.0
41 | 7.94 | 0.0
42 | 7.920000000000001 | 0.0
43 | 7.920000000000001 | 0.0
44 | 7.91 | 0.0
45 | 7.9 | 0.0
46 | 7.9 | 0.0
47 | 7.880000000000001 | 0.0
48 | 7.880000000000001 | 0.0
49 | 7.870000000000001 | 0.0
50 | 7.86 | 0.0
51 | 7.86 | 0.0
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
